bru-star/tiny-mission-control/firmware/Houston/AAFonts.h

#pragma once
#include <stdint.h>

// Anti-aliased glyphs rendered from B612 Mono (SIL OFL 1.1: licenses/OFL-B612.txt).
// Glyphs 32..126 and 127 = the degree sign; 8-bit coverage.
namespace AAFonts {
struct Glyph { uint32_t offset; uint8_t w, h; int8_t x, y; uint8_t advance; };
struct Font { const uint8_t *bits; const Glyph *glyphs; };
const uint8_t AA_SMALL_BITS[5987] = {
    142,231,34,142,231,34,142,231,34,142,231,34,142,231,34,142,231,34,55,86,7,0,0,0,
    126,219,27,182,151,198,98,178,98,182,98,132,79,132,68,0,0,0,5,5,0,5,5,0,
    0,0,98,231,34,79,228,46,0,0,0,114,210,19,103,223,28,0,55,172,217,238,180,217,
    238,172,44,11,34,190,186,34,190,190,32,7,0,17,207,142,11,198,142,0,0,11,61,231,
    117,53,219,122,32,7,64,194,247,194,185,242,194,159,22,0,70,225,46,68,230,63,0,0,
    0,98,223,28,94,230,34,0,0,0,9,1,0,4,1,0,0,0,0,0,7,33,6,0,
    0,0,0,68,198,19,0,0,21,185,242,236,226,179,15,126,209,38,156,17,6,0,142,201,
    31,156,17,0,0,42,226,226,192,19,0,0,0,16,147,251,228,82,0,0,0,68,178,153,
    235,53,0,0,68,169,34,231,98,16,41,69,170,100,225,45,108,237,252,253,225,82,0,0,
    0,70,197,17,0,0,0,0,7,25,1,0,0,0,1,9,0,0,0,0,0,0,38,212,
    222,162,1,111,189,7,0,94,180,34,205,53,204,80,0,0,98,182,34,207,132,185,7,0,
    0,38,213,208,184,206,89,0,0,0,0,11,31,107,192,31,27,1,0,0,0,12,195,164,
    217,211,138,0,0,0,92,197,152,142,68,192,15,0,12,197,92,142,142,70,187,11,0,89,
    195,12,63,230,234,105,0,0,0,0,0,0,4,7,0,0,0,7,158,249,249,160,12,0,
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
    {6488,16,18,0,-18,16},
    {6776,15,18,0,-18,16},
    {7046,15,18,0,-18,16},
    {7316,16,18,0,-18,16},
    {7604,13,18,1,-18,16},
    {7838,14,18,1,-18,16},
    {8090,16,18,0,-18,16},
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
};
const Font AA_TITLE = {AA_TITLE_BITS, AA_TITLE_GLYPHS};
} // namespace AAFonts
