bru-star/tiny-mission-control/firmware/Houston/secrets.example.h

#pragma once
// Copy to secrets.h (git-ignored) and fill in. The ESP32-C6 only joins 2.4 GHz networks.
const char *const WIFI_SSID = "your-2.4-GHz-network";
const char *const WIFI_PASSWORD = "your-password";
// A POSIX time zone string for the clock, for example "EST5EDT,M3.2.0,M11.1.0" or "GMT0BST,M3.5.0/1,M10.5.0".
const char *const TIME_ZONE = "UTC0";
