bru-star/tiny-mission-control/(commit log)

2026-11-04 README: parts list, wiring diagram and Wi-Fi notes
2026-11-08 Hotfix: GPU temperature on the newest Nvidia drivers
    nvidia-smi now prints decimals on these drivers, which the helper could not parse, so the temperature never showed. Round to whole degrees, log an unreadable GPU once, and keep running when the Claude Code settings file is not UTF-8.
